MaryamM4/realtime-voice-translation/component-tests/i2c-addrs-finder/i2c-addrs-finder.ino

// This is not a system component, but used to find
// the LCD's addr for lcd-diplay-from-serial.ino.

// Source:
// https://randomnerdtutorials.com/esp32-esp8266-i2c-lcd-arduino-ide/

#include <Wire.h>

void setup() {
  Wire.begin(21, 22);  // SDA, SCL
  Serial.begin(115200);
  Serial.println("\nI2C Scanner");
}

void loop() {
  byte error, address;
  int nDevices;
  Serial.println("Scanning...");

  nDevices = 0;
  for (address = 1; address <= 127; address++) {
    Wire.beginTransmission(address);
    error = Wire.endTransmission();

    if (error == 0) {
      Serial.print("I2C device found at address 0x");
      if (address < 16) {
        Serial.print("0");
      }
      Serial.println(address, HEX);

      nDevices++;

    } else if (error == 4) {
      Serial.print("Unknown error at address 0x");
      if (address < 16) {
        Serial.print("0");
      }
      Serial.println(address, HEX);
    }
  }

  if (nDevices == 0) {
    Serial.println("No I2C devices found\n");
  } else {
    Serial.println("Done\n");
  }

  delay(2000);
}
