MaryamM4/realtime-voice-translation/(commit log)

2025-05-30 Added all code/docs that existed by May 25 (adc samplers, lcd tests, Design, schedule and status).
2025-05-30 Audio replay (adc-continous-sampler) was very low. Fixed by scaling 12-bit ADC value to 16-bit before transmission.
    [adc-continuous-sampler.ino]
